Max120l/kr1801vp1-055/adapter/adapter_routed.kicad_pcb

## KiCad design adapter/adapter_routed.kicad_pcb (2026-10-15)

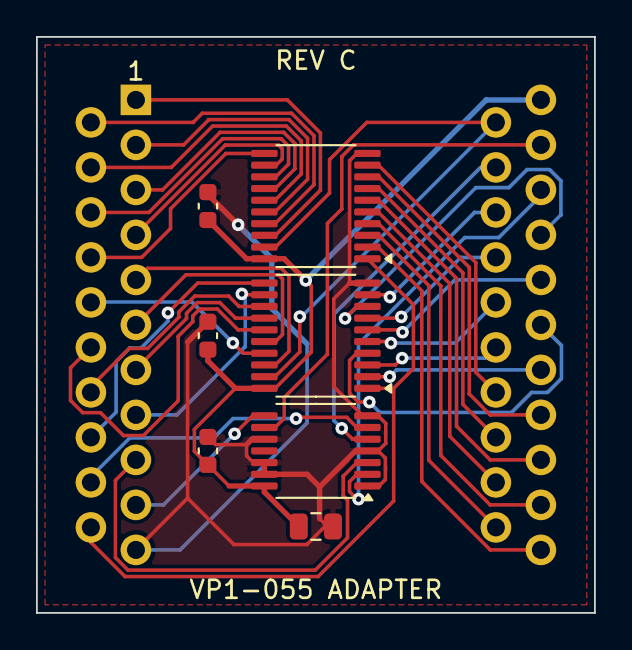
[picture p5: board adapter_routed.kicad_pcb from above]

Board: 2 copper layers, 31.0 x 32.0 mm, 8 parts (0 on the bottom side), 42 nets.

Parts:
C1, C2, C3: 100n; C_0603_1608Metric
C4: 10u; C_0805_2012Metric
J1: VP1-055 site; VP1-055_site
U1, U2: 74AHCT245; TSSOP-20_4.4x6.5mm_P0.65mm
U3: 74AHCT125; TSSOP-14_4.4x5mm_P0.65mm

Connections:
A0: J1.17, U3.3
A1: J1.18, U3.6
A2: J1.19, U3.8
C0: J1.38, U3.2
C1: J1.39, U3.5
C2: J1.40, U3.9
DIR: J1.20, U1.1, U2.1
GND: C1.2, C2.2, C3.2, C4.2, J1.21, U1.10, U2.10, U3.1, U3.4, U3.7, U3.10, U3.12, U3.13
V0: J1.1, U1.18
V1: J1.2, U1.17
V2: J1.3, U1.16
V3: J1.4, U1.15
V4: J1.5, U1.14
V5: J1.6, U1.13
V6: J1.7, U1.12
V7: J1.8, U1.11
VCC: C1.1, C2.1, C3.1, C4.1, J1.42, U1.20, U2.20, U3.14
W0: J1.9, U2.18
W1: J1.10, U2.17
W2: J1.11, U2.16
W3: J1.12, U2.15
W4: J1.13, U2.14
W5: J1.14, U2.13
W6: J1.15, U2.12
W7: J1.16, U2.11
nA0: J1.22, U1.2
nA1: J1.23, U1.3
nA2: J1.24, U1.4
nA3: J1.25, U1.5
nA4: J1.26, U1.6
nA5: J1.27, U1.7
nA6: J1.28, U1.8
nA7: J1.29, U1.9
nA8: J1.30, U2.2
nA9: J1.31, U2.3
nA10: J1.32, U2.4
nA11: J1.33, U2.5
nA12: J1.34, U2.6
nA13: J1.35, U2.7
nA14: J1.36, U2.8
nA15: J1.37, U2.9
nOE: J1.41, U1.19, U2.19
