Max120l/kr1801vp1-055/(commit log)

2026-08-07 Work out what the КР1801ВП1-055 is, and prove a substitute for it
    The part is D22 in the UKNC, it cannot be bought, and a thermal fault in it is
    what the sibling onerom-1801re2 project spent its investigation cornering. This
    repository answers the two questions that were gating a replacement, and proves
    the answer rather than asserting it.
    Both answers come from the 1801BM1/k1801 project's die-level schematic, read
    against that project's own gate-array cell library, so every claim here is
    checkable against two published files.
    **It has no state.** Every cell in the drawing is a gate, a buffer or an
    inverter -- t370, t371, t373, t428, t429, and the two pad cells. No flip-flop,
    no lat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
    [tb_equiv.v, vp1_055_orig.v, vp1_055_repl.v]
2026-08-07 Confirm the polarity without pulling the chip, and rule out delay lines
    The bench procedure assumed the 055 was already out of the machine. On a
    soldered 42-pin planar package whose fault is thermal and intermittent, that
    is the expensive path: the removal risks the only known-marginal specimen,
    and the polarity question does not need it.
    The reading works in place because polarity is direction-independent -- an
    enabled transceiver holds both sides equal whichever way it drives, so pin
    20 never enters the measurement and two channels suffice. Knowing the part
    is enabled comes free from the propagation delay: the follower side lags by
    32.0 ns (V) or 24.5 ns (W), and the uncorrelated stretc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
2026-09-19 The 055 is through-hole, four staggered rows - not planar
    Corrects the package description and reshapes the form-factor section:
    the adapter becomes a 2.5 mm pin field once the site is measured, and the
    site can be socketed with individual machined-pin receptacles.
    Claude-Session: https://claude.ai/code/session_01Vag23esQ6CiLGDPZcUdJPn
2026-09-19 adapter: board generator, routing pipeline and build notes
    The D22 site measured on the machine (2.5 mm row pitch, rows 2.5 mm
    apart, 25 mm outer to outer, 42 through-hole pins in four staggered rows,
    pin 1 at the dimple corner in the outer row) becomes a dictionary at the
    top of build_adapter.py, which writes the KiCad board - two 74AHCT245 and
    a 74AHCT125 in TSSOP on top, the pin field underneath - from the pin map.
    run.sh takes it through Freerouting, a session-file importer of our own
    (pcbnew's works only in the GUI), DRC and gerber export.
    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
2026-09-19 adapter: routed board and gerbers
    Freerouting completes all connections on the first placement; DRC is
    clean. 31 x 32 mm, two layers, 384 segments, 26 vias. Fab package and
    renders included.
    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
    [adapter_routed.kicad_pcb]
2026-09-19 adapter: gerber package now includes the board outline
    kicad-cli names the layer Edge.Cuts; the export list said Edge_Cuts and
    the outline was silently skipped, which the fab caught. Regenerated zip.
    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
2026-09-20 adapter: add BOM.csv with quantities and order codes
    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
    [BOM.csv]
2026-09-20 adapter: BOM with DigiKey/Mouser numbers, matched pin/receptacle pair
    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
    [BOM.csv]
2026-09-21 adapter: BOM notes for generic machined receptacles
    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
    [BOM.csv]
2026-09-29 adapter rev B: pin field 11-10-11-10 (sides are translated copies, not mirrored)
    Rev A mirrored the right-hand side and did not fit the socketed site.
    Re-routed (357 segments, 22 vias, DRC clean), REV B silk mark on both
    sides, finish_adapter restores the design rules before DRC, run.sh SVG
    export uses the right layer name.
    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
    [adapter_routed.kicad_pcb]
2026-09-29 adapter rev C: pin field 10-11-10-11, pin 1 in the inner row
    Counted on the socketed site with pin 1 top-left: the sides are translated
    copies and the 11-pin row is inboard on the pin-1 side. Rev A's right side
    already fitted; only the left side's two rows swap. Re-routed (362
    segments, 22 vias, DRC clean), REV C silk on both sides, pin-1 marker
    directly above the square pad.
    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
    [adapter_routed.kicad_pcb]
2026-09-29 adapter rev C: routing polish - 0.7 mm vias, wider power, GND pours, decoupling next to VCC pins
    Pin field unchanged (drill file identical to the previous rev C). Rerouted
    with 0.2 mm via rings and C2 moved beside U2's VCC pin; polish_adapter.py
    widens VCC/GND where clearance allows and adds GND pours on both layers.
    README gets a routing-practice checklist against the JLCPCB rules.
    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
    [adapter_routed.kicad_pcb]
2026-10-15 It works: fourteen passes of ТЕСТИРОВАНИЕ with ОШИБОК 0
    A substitute has been built and fitted as D22 in the machine this project came
    from. Fourteen consecutive passes of the machine's own ТЕСТИРОВАНИЕ with
    ОШИБОК 0, and over thirty minutes continuous, against an original that failed
    after about ten from cold. The status line said "nothing built yet, nothing
    tested on hardware", which is now the most wrong sentence in the repository.
    The result settles the polarity question outright, and more cheaply than the
    bench check written for it: a non-inverting board cannot run in place of an
    inverting part, so a machine that runs is the confirmation. The same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
2026-10-15 Add a bus stress volume for the worst case ТЕСТИРОВАНИЕ never produces
    Fourteen clean passes say the substitute works. They say nothing about the one
    place it knowingly differs from the original: the gate array staggered its two
    bytes by 7.5 ns so sixteen drivers never switched together, and two identical
    '245s do. ТЕСТИРОВАНИЕ picks its own data and may never once produce that.
    WORST.DAT alternates 0000/FFFF, so every word reverses all sixteen lines at
    once. COUPLE.DAT does 5555/AAAA for adjacent-bit coupling, WALK.DAT walks a
    one and then a zero for the opposite extreme of one line at a time, and
    ADDRS.DAT numbers its own words so a misplaced block reads as misp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
2026-10-15 The worst case passed, measured rather than inferred
    First run on a fodos30 volume. The procedure stopped at DIFFERENCES -- the
    comparator dependency the README flagged as unverified on a clone -- but it
    stopped AFTER the copy and left SCRTCH.DAT on the disk, which turns an aborted
    run into the measurement it was meant to collect.
    That scratch file is byte-for-byte identical to WORST.DAT, all 25600 words.
    So one hundred blocks of alternating 0000/FFFF -- the pattern that reverses all
    sixteen lines on every word, which is precisely what the original's 7.5 ns
    stagger existed to spread -- crossed the bus twice with no error anywhere.
    The lost stagger has been the project's last open logic-ad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
2026-10-15 bustest: chain the copies, because the machine has no comparator
    ?KMON-F-File not found SY:BINCOM.SAV. RT-11's binary compare lives in
    BINCOM.SAV, FODOS 3.0 does not ship it, and no switch fixes a missing utility.
    DIFFERENCES was never going to work on this volume.
    So the comparison moves off the machine and the disk does the one thing a
    missing utility cannot stop it doing. Each pattern is copied down a chain --
    pattern to A, A to B, B to A, deleting behind itself -- and the last link is
    kept. A corrupted word is copied forward faithfully by every later link, so an
    error introduced by ANY link is still in the final file: comparing just that
    file against its pattern detects corruption fr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
2026-10-15 BUSTST.MAC: run the test on the machine instead of a chain
    The chain works around a missing BINCOM.SAV but it is blunt: no feedback until
    the image comes back, and a verdict rather than a diagnosis. The volume
    carries MACRO.SAV, LINK.SAV, SYSMAC.SML and SYSLIB.OBJ, so the test can just
    run there.
    Generates each pattern in memory, writes sixteen blocks, reads them back into a
    second buffer and compares word by word. Both directions cross the bus so both
    count. One line per pass, and on a bad word an immediate line giving the
    block, word, expected, actual and the XOR -- the XOR being the column that
    answers the question the V-against-W asymmetry raises. Low byte alone is the
    group the ori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
2026-10-15 BUSTST: jump to the error handlers, do not branch to them
    First assembly on the machine: three errors, all the same, all mine.
    A 59 000034 103777 BCS ERRENT
    A 61 000216 103777 BCS ERRWRT
    A 63 000256 103777 BCS ERRRD
    A PDP-11 conditional branch reaches +-127 words. The error handlers sit past
    the four pattern generators and the table, several hundred words further on, so
    the offsets pegged at 377 and MACRO flagged each as an addressing error. Each
    BCS is now a BCC over a JMP, which is the usual way round that limit.
    This is the class of bug the Python cross-checks could never have found: the
    arithmetic was right and the instruction was legal, it was the dist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
2026-10-16 The stagger question is closed, cold: 1629 passes, zero errors
    BUSTST ran about ninety-five minutes on the repaired machine.
    PASS 003135 ERRS 000000
    Octal 3135 is 1629 passes: 26,689,536 words compared, 53,379,072 word
    transfers, 101.8 MiB through D22 in 208,512 disk blocks, and not one bad bit.
    WORST.DAT alone accounts for 6,672,384 words of alternating 0000/FFFF -- over
    thirteen million transitions in which all sixteen lines reverse at the same
    instant. That is exactly the event the original's 7.5 ns stagger existed to
    spread and the one thing two identical '245s cannot reproduce.
    That had been the project's longest-standing soft spot. DESIGN.md could only
    argue it: modern decouplin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
2026-10-16 Hot, and still zero errors: the repair is done
    The machine was heated deliberately, with BUSTST running, until the board was
    far too hot to touch. ERRS stayed at zero.
    That is the whole project in one line. The fault this repository exists for
    was thermal and nothing else: the original ran about ten minutes from cold,
    failed, and came back within seconds of being cooled. The black screen, the
    dead keyboard, the hardware reset that did nothing -- all of it hung off
    temperature. A substitute that only passed cold would have proved nothing,
    which is why the heat run had been the one remaining test that could change the
    answer.
    It passes hot, under a pattern deliberately chosen as the wors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
2026-10-16 Put a figure on the hot run, and say how short it was
    Octal 3135 to octal 3267: 90 passes hot, 1,474,560 words, 5.6 MiB, 737,280
    worst-case transitions, zero errors. Run total 1719 passes and 107.4 MiB.
    Five minutes, which the previous commit's wording implied was more. Recorded
    as five minutes, because a result overstated is worth less than a smaller one
    stated exactly -- and because every other number in this repository is precise
    enough that one vague claim would stand out.
    The reason it counts anyway is worth writing down rather than assuming: the
    original's ten minutes was the time it took to heat ITSELF to failure from a
    cold start, whereas the substitute was already far past that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
2026-10-16 The hot run stops at 90 passes, on purpose
    The previous commit left "a longer hot run is cheap" sitting in the docs as if
    it were a todo. It is not one, and recording it as a decision is more useful
    than recording it as an omission.
    Heating a forty-year-old machine for an hour to re-test a part that is
    demonstrably fine puts the risk on everything except the thing being measured:
    the electrolytics, the remaining period ICs, and the adapter's own 10 uF X5R,
    which at +85 C is the lowest-rated component on the board.
    The reasoning that makes 90 passes enough, written down so it does not read as
    a shrug. The question was never whether modern logic survives heat but whether
    the MACHINE still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
2026-10-16 Write the release-edge procedure, with the actual pads to probe
    The last claim in the repository resting on reasoning rather than measurement.
    DESIGN.md has asked for a scope on the nOE release edge since before anything
    was built; everything since is circumstantial, however good -- the machine runs
    cold, hot, and under the worst data the bus can carry.
    Probe points read off the routed board rather than described in general terms.
    nOE is pin 41 and nA0 is pin 22, both on the right-hand edge of the pin field
    24 mm apart, so two probes sit without crossing, and the adapter brings them up
    to 2.5 mm ring pads instead of 0.65 mm TSSOP leads. Pin 41's nearest neighbour
    is pin 42 at +5 V, 2.8 mm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
2026-10-16 Cut the accretion: TESTING.md down 38%, no findings lost
    A day of incremental updates left the docs layered rather than written.
    TESTING.md had grown from about 900 words to 4229 across nineteen headings,
    most of it saying the same things at three different levels of confidence as
    better numbers arrived.
    Cut outright: "The worst case, measured once", an entire section built on one
    clean pass recovered from an aborted run, superseded by a soak with 1629 of
    them. The stagger conclusion was being stated three times -- once as evidence,
    once from that single pass, once from the soak -- and is now stated once, from
    the strongest result.
    Fixed a real editing bug while consolidating. "That is t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
2026-10-16 Photograph of rev C fitted in the machine
    The repository had renders of the board and a page of figures saying it works,
    and no picture of the thing actually in the site it was drawn for. For anyone
    deciding whether to build one, that photograph is worth more than either.
    In the README it goes directly under the status block, because a reader should
    reach the evidence before the die analysis. In adapter/README.md it joins the
    top and bottom renders, where the caption can point at the socketed site --
    individual machined receptacles, so the original, a sourced replacement and
    this board all plug into the same holes.
    The caption also carries the one practical warning the picture makes obvi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
2026-10-19 The part and its replacement, side by side, at the top of the README
    One frame that says what the repository is for: the chip that cannot be bought
    next to the board that replaces it, at the same scale. It goes above the
    status block, because it explains the project faster than the paragraph above
    it does.
    The caption points at the pin geometry, since the photograph shows plainly what
    three board revisions were spent on -- four staggered rows, the two sides
    translated rather than mirrored.
    Stripped EXIF and resized before committing. The original carried twelve GPS
    entries and this repository is public; it was also 5.4 MB, which is not a
    README image. Now 1600 px and 280 KB with no meta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
